FT9R/Nixie-Clock/Production files/BOM.csv

ID | Name | Designator | Footprint | Quantity | Manufacturer Part | Manufacturer | link
1 | 470uF | C1,C10 | CAP-TH_BD10.0-P5.00-D1.0-FD | 2 | UPM1H820MPD6 |  | https://www.chipdip.ru/product0/9000313085
2 | 10uF | C2,C3,C5,C7,C8,C11,C13,C15 | C1206 | 8 | GRM31CR71E106KA12L | MuRata | https://www.chipdip.ru/product/grm31cr71e106ka12l
3 | 100nF | C4,C6,C9,C16,C18,C19,C20,C22 | C1206 | 8 | GRM319R71H104KA01D | MuRata | https://www.chipdip.ru/product/grm319r71h104k
4 | 10uF | C12 | CAP-TH_BD10.0-P5.00-D1.0-FD | 1 | UPM1H820MPD6 |  | https://www.chipdip.ru/product0/9000383642
5 | 100nF | C14 | C1206 | 1 | GRM31CR72E104KW03L | MuRata | https://www.chipdip.ru/product/grm31cr72e104k
6 | 24pF | C17 | C0805 | 1 | GRM2165C1H240J | Murata Electronics | https://www.chipdip.ru/product/grm2165c1h240j
7 | 1F | C21 | CAP-TH_BD19.0-P20.00-D1.2-R-RD | 1 | EECS5R5H105 | PANASONIC | https://www.chipdip.ru/product0/8843089250
8 | US1G-E3/61T | D1,D2,D3,D4,D5,D6,D7,D8,D9 | SMA_L4.4-W2.8-LS5.4-RD | 9 | US1G-E3/61T | Vishay Intertech | https://www.chipdip.ru/product/us1g-e3-61t-vishay
9 | MMSZ5267BT1G | D10,D11,D12,D13,D14,D15,D16,D17,D18,D19,D20,D21 | SOD-123_L2.7-W1.6-LS3.7-RD | 12 | MMSZ5267BT1G | ON Semicon
10 | B82477G4105M | L1 | B82477G4105M | 1 | Epcos/TDK |  | https://www.chipdip.ru/product/b82477g4105m
11 | MMBTA42LT1G | Q1,Q2,Q3,Q4,Q6,Q7,Q8,Q9,Q10,Q11,Q12,Q13 | SOT-23-3_L2.9-W1.6-P1.90-LS2.8-BR | 12 | MMBTA42LT1G | ON | https://www.chipdip.ru/product/mmbta42lt1-onsemi
12 | STD17NF25 | Q5 | TO-252-3_L6.5-W5.8-P4.58-BR | 1 | STD17NF25 | STMicroelectronics | https://www.chipdip.ru/product/std17nf25
13 | 390 | R1 | R0805 | 1 | ERA6VEB1001V | PANASONIC
14 | 1K | R2,R3,R4,R7,R8,R9,R10,R12,R13,R14,R15,R18,R19,R28 | R0805 | 14 | ERA6VEB1001V | PANASONIC
15 | 47 | R5 | R0805 | 1 | ERA6VEB1001V | PANASONIC
16 | 10K | R6,R16,R17 | R0805 | 3 | ERA6VEB1001V | PANASONIC
17 | 220K | R11 | R2512 | 1 | CRCW2512240KJNEG | Vishay Intertech
18 | 22 | R27 | R0805 | 1 | ERA6VEB1001V | PANASONIC
19 | 20K | R29 | R2512 | 1 | CRCW2512240KJNEG | Vishay Intertech
20 | 510K | R30,R31,R32,R33,R34,R35 | R0805 | 6 | ERA6VEB1001V | PANASONIC
21 | МКА-10110 | U1 | МКА-10110 | 1 |  |  | https://www.chipdip.ru/product/mka-10110-a
22 | TLP350(TP1,F) | U2 | SMD-8_L9.6-W6.4-P2.54-LS9.6-BL | 1 | TLP350(TP1,F) | TOSHIBA | https://www.chipdip.ru/product/tlp350-tp5-f
23 | NCP1117ST50T3G | U3 | SOT-223_L6.5-W3.5-P2.30-LS7.0-BR | 1 | NCP1117ST50T3G | ON | https://www.chipdip.ru/product/ncp1117st50t3g-2
24 | IN-16 VERTICAL | U4,U5,U7,U12,U13,U20 | IN-16 VERTICAL | 6
25 | DIGISPARK | U6 | DIGISPARK | 1
26 | HEF4028BT,653 | U8,U9 | SO-16_L9.9-W3.9-P1.27-LS6.0-BL | 2 | HEF4028BT,653 | Nexperia | https://www.chipdip.ru/product/hef4028bt
27 | LM75AD | U10 | SOIC-8_L5.0-W4.0-P1.27-LS6.0-BL | 1 | LM75AD | NXP | https://www.chipdip.ru/product/lm75ad.118
28 | PCF8563T/5,518 | U11 | SOIC-8_L5.0-W4.0-P1.27-LS6.0-BL | 1 | PCF8563T/5,518 | NXP | https://www.chipdip.ru/product/pcf8563t-5.518
29 | TLP127(TPL,U,F) | U14,U15,U16,U17,U18,U19 | SOP-4_L3.6-W4.4-P2.54-LS7.0-BR | 6 | TLP127(TPL,U,F) | TOSHIBA | https://www.chipdip.ru/product/tlp127
30 | 32.768KHz | X1 | OSC-SMD_L3.2-W1.5 | 1 | NX3215SA-32.768KHZ(STD-MUA-8) | Nihon Dempa Kogyo | https://www.chipdip.ru/product0/9000523964
31 | DC-005-2.0 | XS1 | DC-IN-TH_DC-005-2.0 | 1 | DC-005-2.0 | USAKRO(美韩) | https://www.chipdip.ru/product/dc-005
