FT9R/Nixie-Clock/(list of files, drawings)

Other design files:
DigisparkPID.pdsprj
